BrianEnigma/Panoramical-Controller/Hardware/README.md

#Panoramical MIDI Controller — Electronics

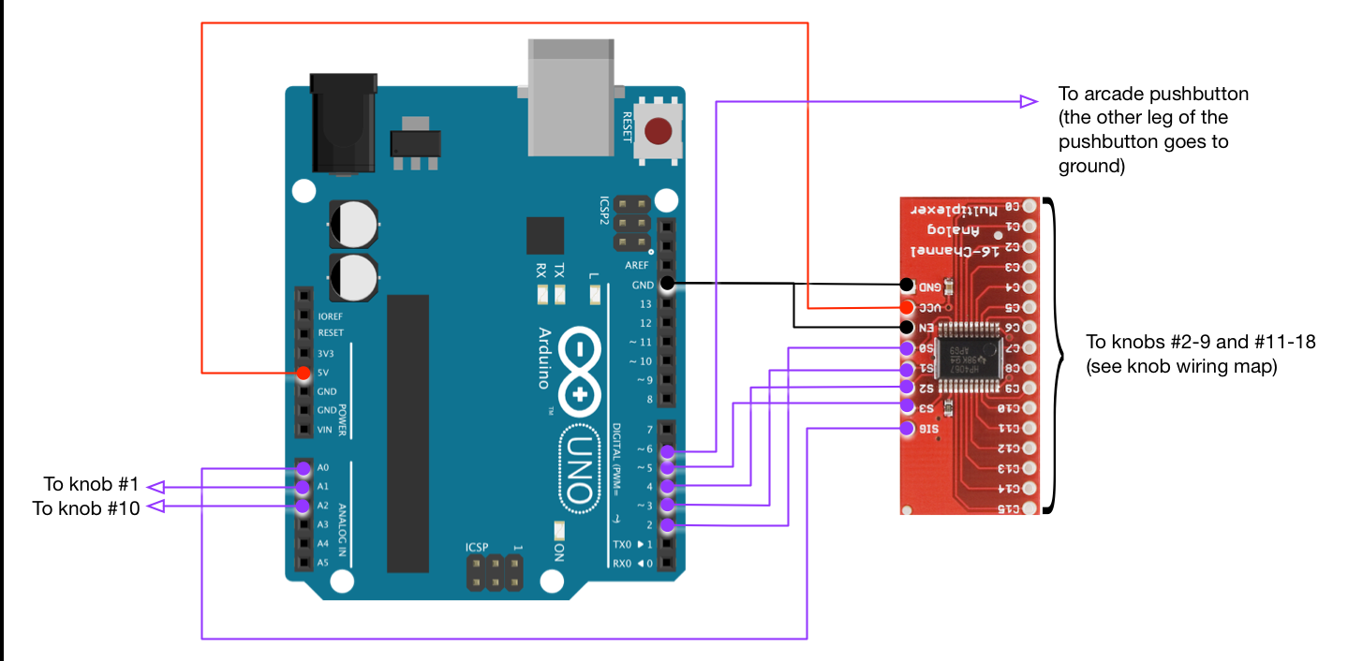
[picture p3: Hardware/schematics.png]
Schematics


You will need to wire up the potentiometers based on the following pin map:

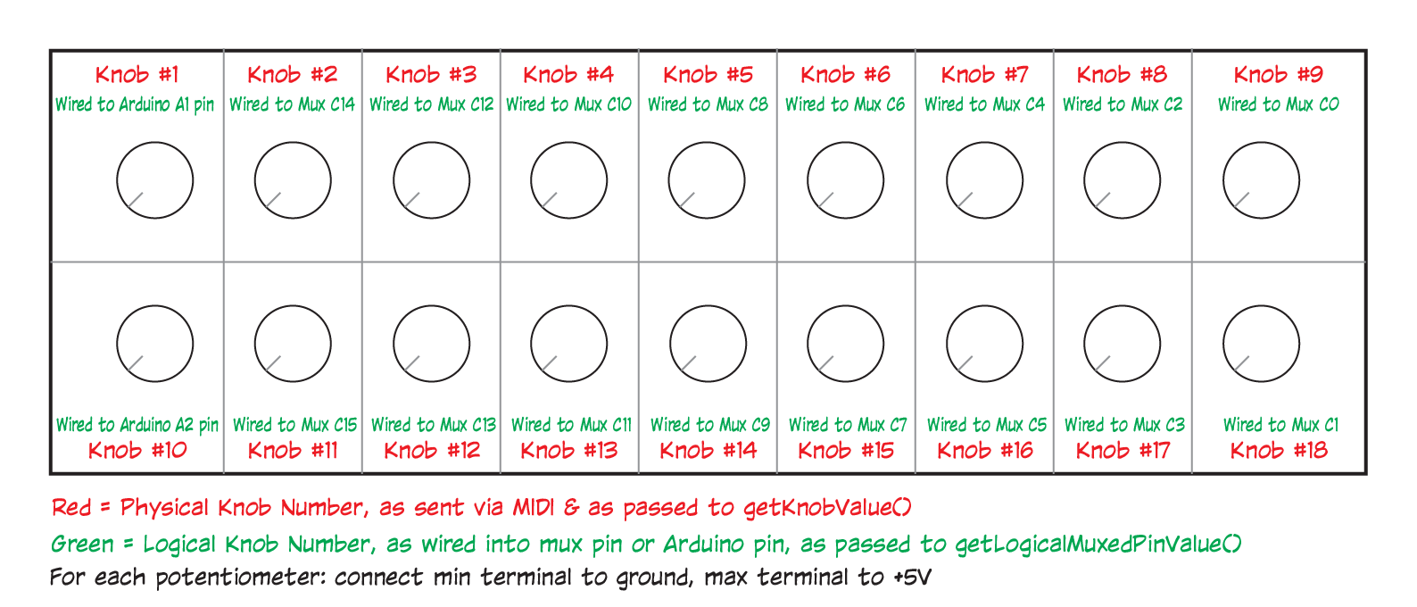
[picture p4: Hardware/pin_map.png]
Front Panel
