BrianEnigma/Panoramical-Controller/Hardware/arduino_Uno_Rev3_breadboard.png

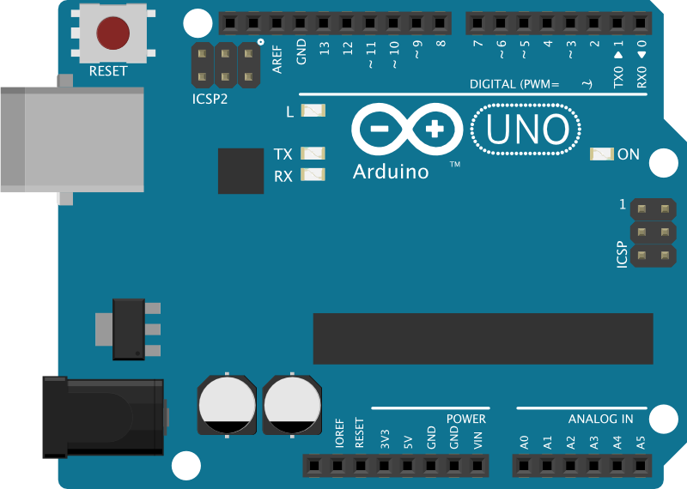
Hardware/arduino_Uno_Rev3_breadboard.png
