BrianEnigma/Panoramical-Controller/Hardware/schematics.graffle/image2.png

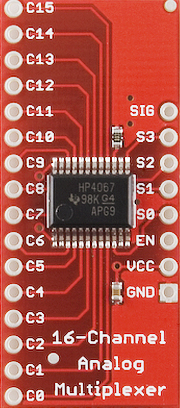
Hardware/schematics.graffle/image2.png
