BrianEnigma/Panoramical-Controller/(commit log)

2016-04-03 Fixes for current available wood size and thickness @ Ponoko
2016-04-23 Add in code for arcade button
2016-04-23 Debouncer for arcade button
2016-05-30 Migrate from Teensy to Arduino.
    Immediate open issues:
    - The "Advance" pushbutton either needs to send a 3-second long note or
    it needs to send a note for as long as it's held down.
    - The full 18 controls should send an update every n seconds to re-sync
    their positions, for example when you switch from one animation to the
    next, the next doesn't see their values and assumes everything is
    still at zero.
    [Software.ino]
2016-05-30 Firmware for Arduino USB serial port.
    - Firmware for regular serial operation + firmware for hiduino MIDI
    operation.
    - Shell script to swap back and forth.
2016-06-12 Fix remaining two known issues:
    1. Pushbutton signals when you press/release rather than for an
    arbitrary duration.
    2. Knobs force-send updates every 3 seconds.
    [Software.ino]
2016-06-16 Update with enclosure/build pics.
